SzymonLy/Quadcopter_2.1/CanSat.kicad_sch

## KiCad design CanSat.kicad_sch (2025-03-13)

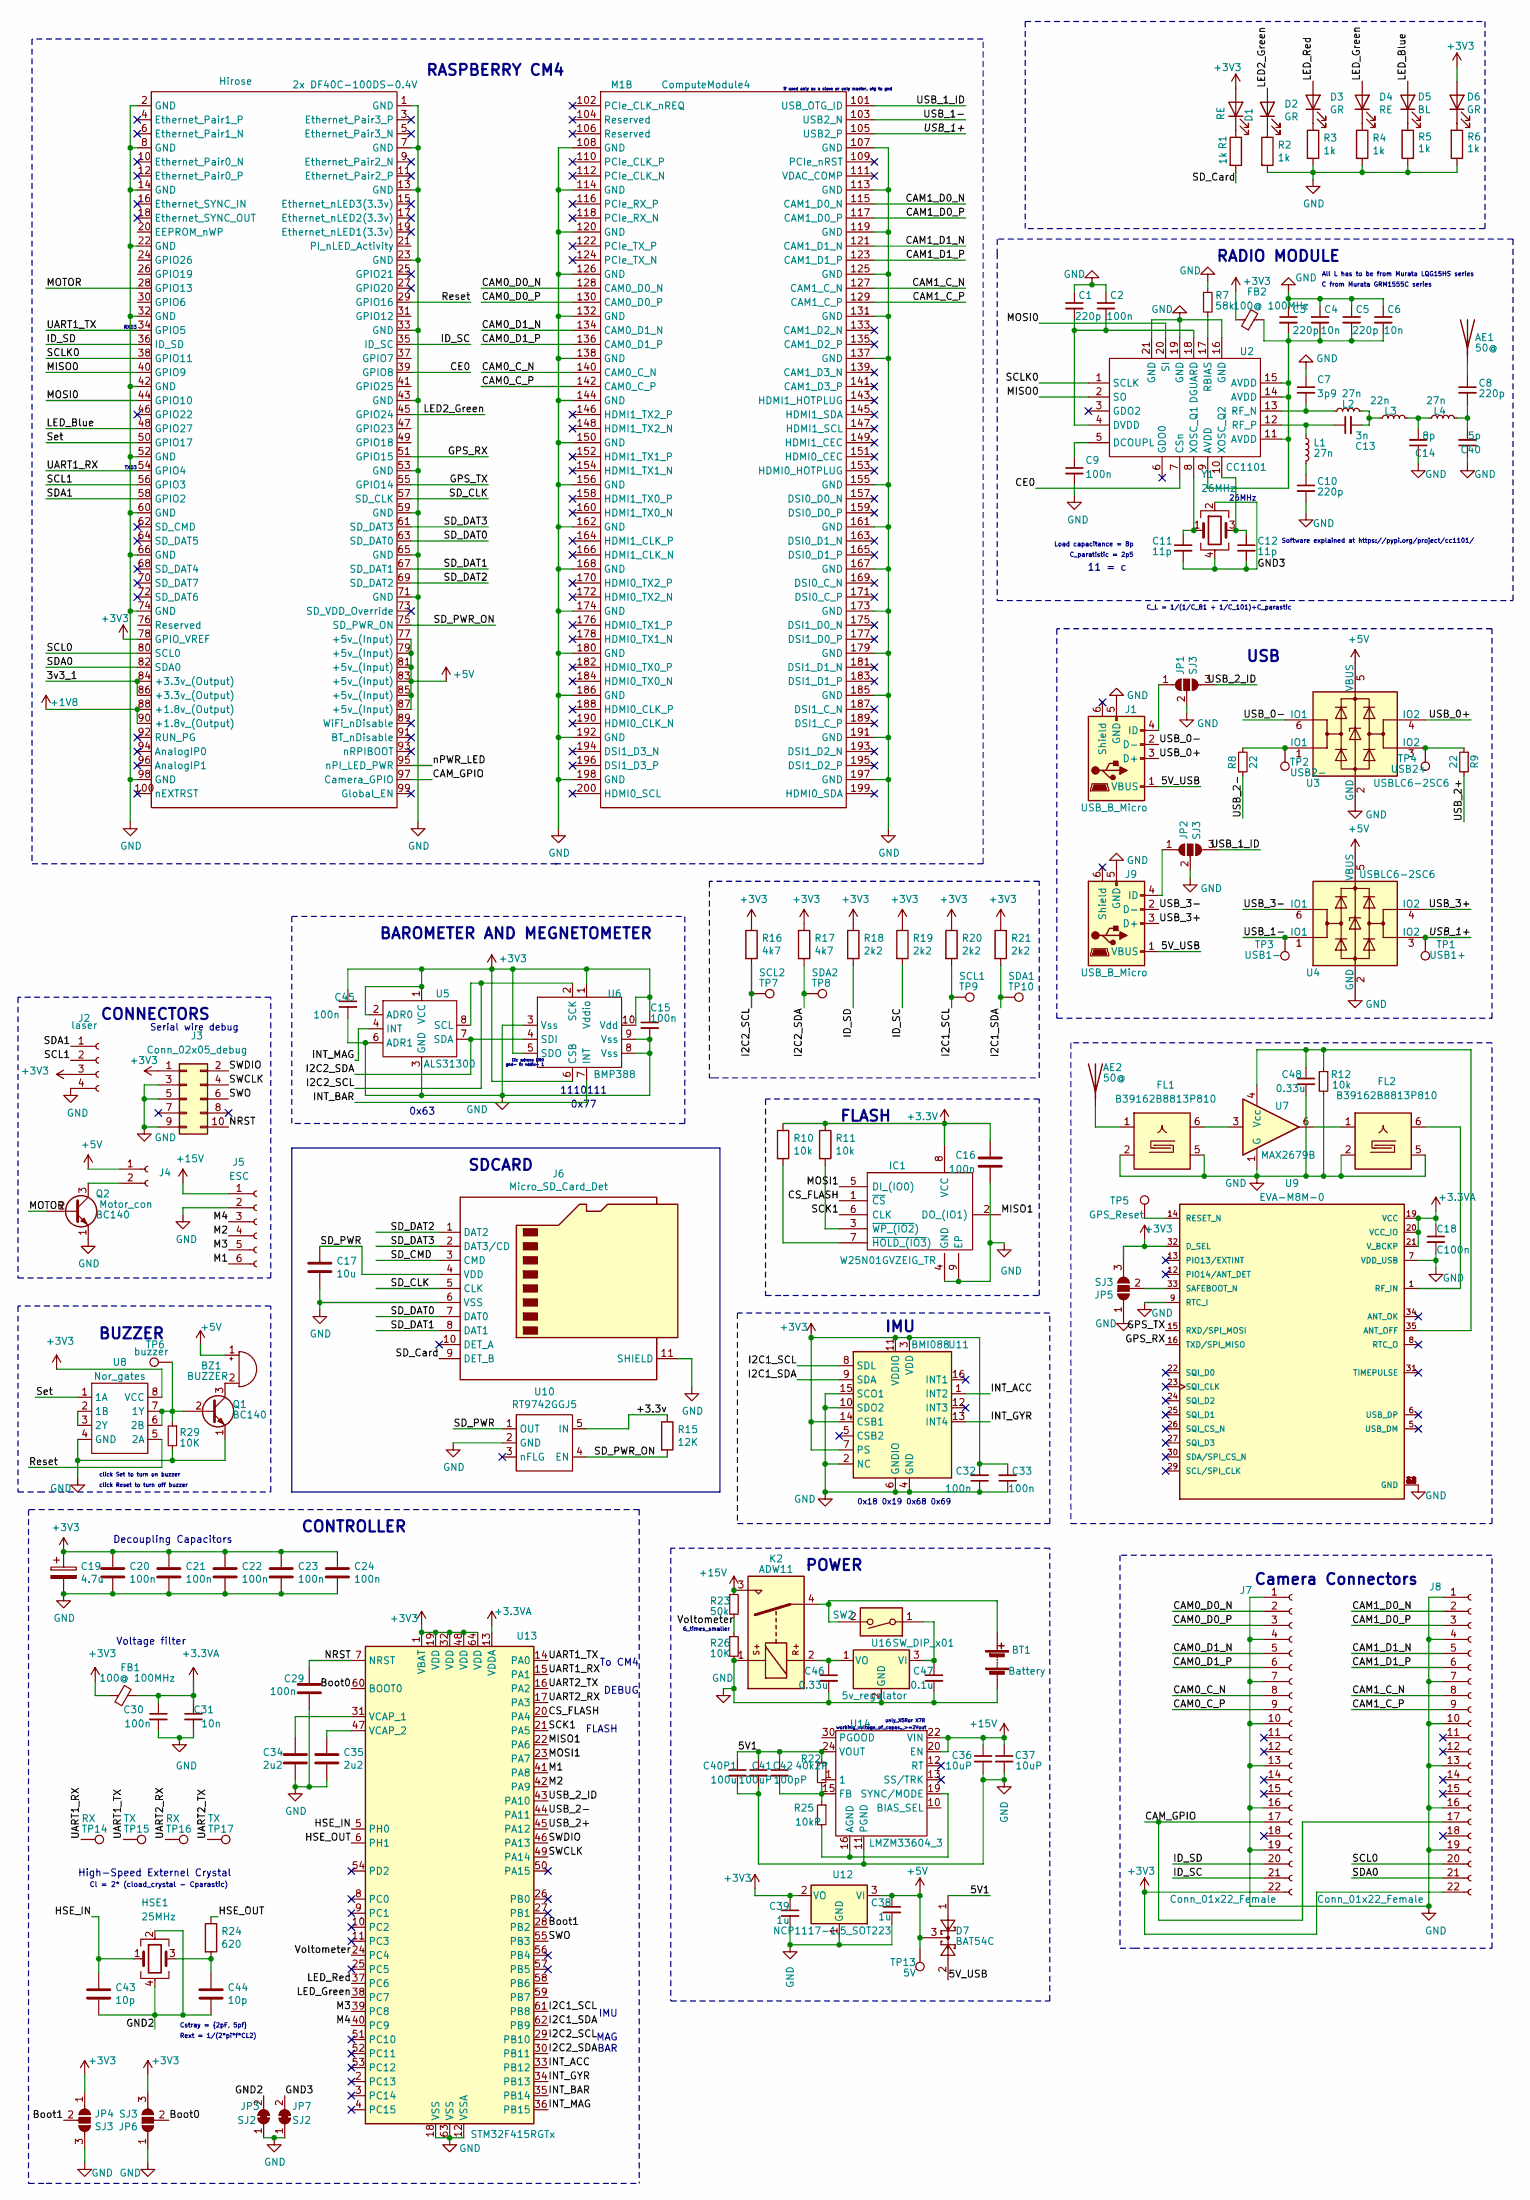
[picture p9: schematic CanSat.kicad_sch]

Parts:
AE1: 50@; 433_antenna_connector
AE2: 50@; GPS_antenna
BT1: Battery; Battery con
BZ1: BUZZER; buzzer
C1, C3, C5, C8, C10: 220p; C_0402_1005Metric
C2, C9, C15, C16, C20, C21, C22, C23, C24, C29, C30, C32, C33, C45: 100n; C_0402_1005Metric
C4, C6, C31: 10n; C_0402_1005Metric
C7: 3p9; C_0402_1005Metric
C11, C12: 11p; C_0402_1005Metric
C13: 3n; C_0402_1005Metric
C14: 8p; C_0402_1005Metric
C17: 10u; C_0402_1005Metric; Part Description 10uF 10% 10V Ceramic Capacitor X7R 0805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
C18: C100n; C_0402_1005Metric
C19: 4.7u; C_0402_1005Metric
C34, C35: 2u2; C_0402_1005Metric
C36, C37: 10uP; C10uF_Power
C38, C39: 1u; C_0402_1005Metric
C40: 5p; C_0402_1005Metric
C40P1: 100u; C10uF_Power
C41: 100uP; C10uF_Power
C42: 100pP; C_0402_1005Metric
C43, C44: 10p; C_0402_1005Metric
C46: 0.33u; C_0402_1005Metric
C47: 0.1u; C_0402_1005Metric
C48: 0.33u; C_0201_0603Metric
D1, D4: RE; diode_XQ-E
D2, D3: GR; diode_XQ-E
D5: BL; diode_XQ-E; Part Description Green 572nm LED Indication - Discrete 2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
D6: GR; diode_XQ-E; Part Description Green 572nm LED Indication - Discrete 2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
D7: BAT54C; SOT-23
FB1, FB2: 100@ 100MHz; L_0603_1608Metric
FL1, FL2: B39162B8813P810; SOT-23-6
HSE1: 25MHz; Crystal_SMD_Abracon_ABM8G-4Pin_3.2x2.5mm
IC1: W25N01GVZEIG_TR; Flash; Manufacturer_Part_Number W25N01GVZEIG TR; Mouser Part Number 454-W25N01GVZEIGTR
J1, J9: USB_B_Micro; GCT_USB3160-30-0170-0-C
J2: laser; Laser
J3: Conn_02x05_debug; Debug_connector
J4: Motor_con; Motor_connection
J5: ESC; ESC_power
J6: Micro_SD_Card_Det; GCT_MEM2075-00-140-01-A; Part Description 9 (8 + 1) Position Card Connector micro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
J7, J8: Conn_01x22_Female; Hirose_FH12-22S-0.5SH_1x22-1MP_P0.50mm_Horizontal; Part Description 22 Position FFC, FPC Connector Contacts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
JP1, JP2, JP4, JP5, JP6: SJ3; SolderJumper-3_P1.3mm_Open_RoundedPad1.0x1.5mm
JP3, JP7: SJ2; SolderJumper-2_P1.3mm_Bridged2Bar_RoundedPad1.0x1.5mm
K2: ADW11; relay
L1, L2, L4: 27n; R_0402_1005Metric
L3: 22n; R_0402_1005Metric
M1: ComputeModule4; Raspberry-Pi-4-Compute-Module
Q1, Q2: BC140; SOT-23
R1, R5, R6: 1k; R_0402_1005Metric; Part Description Resistor 1K M1005 1% 63mW
R2, R3, R4: 1k; R_0402_1005Metric
R7: 58k; R_0402_1005Metric
R8, R9: 22; R_0402_1005Metric
R10, R11, R12: 10k; R_0402_1005Metric
R15: 12K; R_0402_1005Metric; Part Description Resistor 12K M1005 1% 63mW
R16, R17: 4k7; R_0402_1005Metric
R18, R19, R20, R21: 2k2; R_0402_1005Metric
R22: 40k2P; R_1k
R23: 50k; R_0402_1005Metric
R24: 620; R_0402_1005Metric
R25: 10kP; R_0402_1005Metric
R26, R29: 10K; R_0402_1005Metric
SW2: SW_DIP_x01; Switch
TP1: USB1+; TestPoint_Pad_D1.5mm
TP2: USB2-; TestPoint_Pad_D1.5mm
TP3: USB1-; TestPoint_Pad_D1.5mm
TP4: USB2+; TestPoint_Pad_D1.5mm
TP5: GPS_Reset; TestPoint_Pad_D1.5mm
TP6: buzzer; TestPoint_Pad_D1.5mm
TP7: SCL2; TestPoint_Pad_D1.5mm
TP8: SDA2; TestPoint_Pad_D1.5mm
TP9: SCL1; TestPoint_Pad_D1.0mm
TP10: SDA1; TestPoint_Pad_D1.0mm
TP13: 5V; TestPoint_Pad_D2.0mm
TP14, TP16: RX; TestPoint_Pad_D1.5mm
TP15, TP17: TX; TestPoint_Pad_D1.5mm
U2: CC1101; Transmiter
U3, U4: USBLC6-2SC6; SOT-23-6
U5: ALS31300; Mag
U6: BMP388
U7: MAX2679B; DFN150X100X80-6N
U8: Nor_gates
U9: EVA-M8M-0; GPS; PART_REV R02
U10: RT9742GGJ5; SOT-23-5; Part Description Power Switch/Driver 1:1 N-Channel 1A TS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
U11: BMI088
U12: NCP1117-1.5_SOT223; SOT-223-3_TabPin2
U13: STM32F415RGTx; LQFP-64_10x10mm_P0.5mm
U14: LMZM33604_3; 5V_converter
U16: 5v_regulator; Reg_5v
Y1: 26MHz; Crystal_SMD_EuroQuartz_MT-4Pin_3.2x2.5mm

Connections:
3v3_1: M1.84 (+3.3v_(Output)), M1.86 (+3.3v_(Output))
5V1: C40P1.1, C41.1, C42.1, D7.1, R22.1, U14.24 (VOUT)
5V_USB: D7.2, J1.1 (VBUS), J9.1 (VBUS)
+1V8: M1.88 (+1.8v_(Output)), M1.90 (+1.8v_(Output))
+3.3VA: C18.1, C30.1, C31.1, FB1.2, U9.19 (VCC), U9.20 (VCC_IO), U9.21 (V_BCKP), U13.13 (VDDA)
+3.3v: C16.2, IC1.8 (VCC), R10.1, R11.1, R15.1, U10.5 (IN)
+3V3: C15.1, C19.1, C20.1, C21.1, C22.1, C23.1, C24.1, C32.2, C33.2, C39.1, C45.1, D1.2 (A), D6.2 (A), FB1.1, FB2.1, J2.3, J3.1, J7.22, J8.22, JP4.1 (A), JP5.3 (B), JP6.3 (B), M1.78 (GPIO_VREF(1.8v/3.3v_Input)), R16.1, R17.1, R18.1, R19.1, R20.1, R21.1, U5.1 (VCC), U5.2 (ADR0), U6.1 (Vddio), U6.5 (SDO), U6.6 (CSB), U6.10 (Vdd), U8.8 (VCC), U9.32 (D_SEL), U11.3 (VDD), U11.7 (PS), U11.11 (VDDIO), U11.14 (CSB1), U12.2 (VO), U13.1 (VBAT), U13.19 (VDD), U13.32 (VDD), U13.48 (VDD), U13.64 (VDD)
+5V: BZ1.1 (-), C38.1, D7.3, J4.1, M1.77 (+5v_(Input)), M1.79 (+5v_(Input)), M1.81 (+5v_(Input)), M1.83 (+5v_(Input)), M1.85 (+5v_(Input)), M1.87 (+5v_(Input)), TP13.1, U3.5 (VBUS), U4.5 (VBUS), U12.3 (VI)
+15V: C36.1, C37.1, J5.1, K2.3, R23.1, U14.20 (EN), U14.22 (VIN)
Boot0: JP6.2 (C), U13.60 (BOOT0)
Boot1: JP4.2 (C), U13.28 (PB2)
CAM0_C_N: J7.8, M1.140 (CAM0_C_N)
CAM0_C_P: J7.9, M1.142 (CAM0_C_P)
CAM0_D0_N: J7.2, M1.128 (CAM0_D0_N)
CAM0_D0_P: J7.3, M1.130 (CAM0_D0_P)
CAM0_D1_N: J7.5, M1.134 (CAM0_D1_N)
CAM0_D1_P: J7.6, M1.136 (CAM0_D1_P)
CAM1_C_N: J8.8, M1.127 (CAM1_C_N)
CAM1_C_P: J8.9, M1.129 (CAM1_C_P)
CAM1_D0_N: J8.2, M1.115 (CAM1_D0_N)
CAM1_D0_P: J8.3, M1.117 (CAM1_D0_P)
CAM1_D1_N: J8.5, M1.121 (CAM1_D1_N)
CAM1_D1_P: J8.6, M1.123 (CAM1_D1_P)
CAM_GPIO: J7.17, J8.17, M1.97 (Camera_GPIO)
CE0: M1.39 (GPIO8), U2.7 (CSn)
CS_FLASH: IC1.1 (~CS), U13.20 (PA4)
GND: BT1.2 (-), C1.1, C2.1, C3.1, C4.1, C5.1, C6.1, C7.1, C9.2, C10.2, C14.1, C15.2, C16.1, C17.2, C18.2, C19.2, C20.2, C21.2, C22.2, C23.2, C24.2, C29.2, C30.2, C31.2, C32.1, C33.1, C34.2, C35.2, C36.2, C37.2, C38.2, C39.2, C40.1, C40P1.2, C41.2, C45.2, C46.2, C47.2, C48.2, FL1.2, FL1.5, FL2.2, FL2.5, IC1.4 (GND), IC1.9 (EP), J1.5 (GND), J2.4, J3.3, J3.5, J3.9, J5.2, J6.6 (VSS), J6.11 (SHIELD), J7.1, J7.4, J7.7, J7.10, J7.13, J7.16, J7.19, J8.1, J8.4, J8.7, J8.10, J8.13, J8.16, J8.19, J9.5 (GND), JP1.2 (C), JP2.2 (C), JP3.1 (A), JP4.3 (B), JP5.1 (A), JP6.1 (A), JP7.1 (A), K2.1, M1.1 (GND), M1.2 (GND), M1.7 (GND), M1.8 (GND), M1.13 (GND), M1.14 (GND), M1.22 (GND), M1.23 (GND), M1.32 (GND), M1.33 (GND), M1.42 (GND), M1.43 (GND), M1.52 (GND), M1.53 (GND), M1.59 (GND), M1.60 (GND), M1.65 (GND), M1.66 (GND), M1.71 (GND), M1.74 (GND), M1.98 (GND), M1.107 (GND), M1.108 (GND), M1.113 (GND), M1.114 (GND), M1.119 (GND), M1.120 (GND), M1.125 (GND), M1.126 (GND), M1.131 (GND), M1.132 (GND), M1.137 (GND), M1.138 (GND), M1.144 (GND), M1.150 (GND), M1.155 (GND), M1.156 (GND), M1.161 (GND), M1.162 (GND), M1.167 (GND), M1.168 (GND), M1.173 (GND), M1.174 (GND), M1.179 (GND), M1.180 (GND), M1.185 (GND), M1.186 (GND), M1.191 (GND), M1.192 (GND), M1.197 (GND), M1.198 (GND), Q1.1 (E), Q2.1 (E), R2.2, R3.2, R4.2, R5.1, R6.1, R7.1, R12.2, R26.2, R29.2, U2.16 (GND), U2.19 (GND), U2.21 (GND), U3.2 (GND), U4.2 (GND), U5.3 (GND), U5.6 (ADR1), U6.3 (Vss), U6.8 (Vss), U6.9 (Vss), U7.1 (G), U8.4 (GND), U9.2 (GND), U9.7 (VDD_USB), U9.9 (RTC_I), U9.18 (GND), U9.37 (GND), U9.38 (GND), U9.39 (GND), U9.40 (GND), U9.41 (GND), U9.42 (GND), U9.43 (GND), U10.2 (GND), U11.2 (NC), U11.4 (GND), U11.6 (GNDIO), U11.10 (SDO2), U11.15 (SCO1), U12.1 (GND), U13.12 (VSSA), U13.18 (VSS), U13.63 (VSS), U14.11 (PGND), U16.2 (GND)
GND2: C43.2, C44.2, HSE1.2, HSE1.4, JP3.2 (B)
GND3: C11.2, C12.2, JP7.2 (B), Y1.2, Y1.4
GPS_RX: M1.51 (GPIO15), U9.16 (TXD/SPI_MISO)
GPS_TX: M1.55 (GPIO14), U9.15 (RXD/SPI_MOSI)
HSE_IN: C43.1, HSE1.1, U13.5 (PH0)
HSE_OUT: R24.1, U13.6 (PH1)
I2C1_SCL: R20.2, TP9.1, U11.8 (SDL), U13.61 (PB8)
I2C1_SDA: R21.2, TP10.1, U11.9 (SDA), U13.62 (PB9)
I2C2_SCL: R16.2, TP7.1, U5.8 (SCL), U6.2 (SCK), U13.29 (PB10)
I2C2_SDA: R17.2, TP8.1, U5.7 (SDA), U6.4 (SDI), U13.30 (PB11)
ID_SC: J7.21, M1.35 (ID_SC), R19.2
ID_SD: J7.20, M1.36 (ID_SD), R18.2
INT_ACC: U11.1 (INT2), U13.33 (PB12)
INT_BAR: U6.7 (INT), U13.35 (PB14)
INT_GYR: U11.13 (INT4), U13.34 (PB13)
INT_MAG: U5.4 (INT), U13.36 (PB15)
LED2_Green: D2.2 (A), M1.45 (GPIO24)
LED_Blue: D5.2 (A), M1.48 (GPIO27)
LED_Green: D4.2 (A), U13.38 (PC7)
LED_Red: D3.2 (A), U13.37 (PC6)
M1: J5.6, U13.41 (PA8)
M2: J5.4, U13.42 (PA9)
M3: J5.5, U13.39 (PC8)
M4: J5.3, U13.40 (PC9)
MISO0: M1.40 (GPIO9), U2.2 (SO)
MISO1: IC1.2 (DO_(IO1)), U13.22 (PA6)
MOSI0: M1.44 (GPIO10), U2.20 (SI)
MOSI1: IC1.5 (DI_(IO0)), U13.23 (PA7)
MOTOR: M1.28 (GPIO13), Q2.2 (B)
NRST: C29.1, J3.10, U13.7 (NRST)
unnamed: AE1.1, C8.1
unnamed: AE2.1, FL1.1
unnamed: BT1.1 (+), K2.4, SW2.2
unnamed: BZ1.2 (+), Q1.3 (C)
unnamed: C1.2, C2.2, U2.4 (DVDD), U2.18 (DGUARD)
unnamed: C3.2, C4.2, C5.2, C6.2, FB2.2, U2.9 (AVDD), U2.11 (AVDD), U2.14 (AVDD), U2.15 (AVDD)
unnamed: C7.2, L2.1, U2.13 (RF_N)
unnamed: C9.1, U2.5 (DCOUPL)
unnamed: C10.1, L1.2
unnamed: C11.1, U2.8 (XOSC_Q1), Y1.1
unnamed: C12.1, U2.10 (XOSC_Q2), Y1.3
unnamed: C13.1, L1.1, U2.12 (RF_P)
unnamed: C13.2, L2.2, L3.1
unnamed: C14.2, L3.2, L4.1
unnamed: C34.1, U13.31 (VCAP_1)
unnamed: C35.1, U13.47 (VCAP_2)
unnamed: C8.2, C40.2, L4.2
unnamed: C42.2, R22.2, R25.1, U14.15 (FB)
unnamed: C44.1, HSE1.3, R24.2
unnamed: C46.1, K2.2, U16.1 (VO)
unnamed: C47.1, SW2.1, U16.3 (VI)
unnamed: C48.1, R12.1, U7.4 (Vcc), U9.35 (ANT_OFF)
unnamed: D1.1 (K), R1.1
unnamed: D2.1 (K), R2.1
unnamed: D3.1 (K), R3.1
unnamed: D4.1 (K), R4.1
unnamed: D5.1 (K), R5.2
unnamed: D6.1 (K), R6.2
unnamed: FL1.6, U7.3
unnamed: FL2.1, U7.6
unnamed: FL2.6, U9.1 (RF_IN)
unnamed: IC1.3 (~WP_(IO2)), R11.2
unnamed: IC1.7 (~HOLD_(IO3)), R10.2
unnamed: J1.4 (ID), JP1.1 (A)
unnamed: J4.2, Q2.3 (C)
unnamed: J9.4 (ID), JP2.1 (A)
unnamed: JP5.2 (C), U9.33 (SAFEBOOT_N)
unnamed: Q1.2 (B), R29.1, TP6.1, U8.6 (2B), U8.7 (1Y)
unnamed: R7.2, U2.17 (RBIAS)
unnamed: R8.2, TP2.1, U3.1 (IO1)
unnamed: R9.1, TP4.1, U3.3 (IO2)
unnamed: R25.2, U14.16 (AGND), U14.19 (SYNC/MODE)
unnamed: TP5.1, U9.14 (RESET_N)
unnamed: U8.2 (1B), U8.3 (2Y)
Reset: M1.29 (GPIO16), U8.5 (2A)
SCK1: IC1.6 (CLK), U13.21 (PA5)
SCL0: J8.20, M1.80 (SCL0)
SCL1: J2.2, M1.56 (GPIO3)
SCLK0: M1.38 (GPIO11), U2.1 (SCLK)
SDA0: J8.21, M1.82 (SDA0)
SDA1: J2.1, M1.58 (GPIO2)
SD_CLK: J6.5 (CLK), M1.57 (SD_CLK)
SD_CMD: J6.3 (CMD)
SD_Card: J6.9 (DET_B), R1.2
SD_DAT0: J6.7 (DAT0), M1.63 (SD_DAT0)
SD_DAT1: J6.8 (DAT1), M1.67 (SD_DAT1)
SD_DAT2: J6.1 (DAT2), M1.69 (SD_DAT2)
SD_DAT3: J6.2 (DAT3/CD), M1.61 (SD_DAT3)
SD_PWR: C17.1, J6.4 (VDD), U10.1 (OUT)
SD_PWR_ON: M1.75 (SD_PWR_ON), R15.2, U10.4 (EN)
SWCLK: J3.4, U13.49 (PA14)
SWDIO: J3.2, U13.46 (PA13)
SWO: J3.6, U13.55 (PB3)
Set: M1.50 (GPIO17), U8.1 (1A)
UART1_RX: M1.54 (GPIO4), TP14.1, U13.15 (PA1)
UART1_TX: M1.34 (GPIO5), TP15.1, U13.14 (PA0)
UART2_RX: TP16.1, U13.17 (PA3)
UART2_TX: TP17.1, U13.16 (PA2)
USB_0+: J1.3 (D+), U3.4 (IO2)
USB_0-: J1.2 (D-), U3.6 (IO1)
USB_1+: M1.105 (USB2_P), TP1.1, U4.3 (IO2)
USB_1-: M1.103 (USB2_N), TP3.1, U4.1 (IO1)
USB_1_ID: JP2.3 (B), M1.101 (USB_OTG_ID)
USB_2+: R9.2, U13.45 (PA12)
USB_2-: R8.1, U13.44 (PA11)
USB_2_ID: JP1.3 (B), U13.43 (PA10)
USB_3+: J9.3 (D+), U4.4 (IO2)
USB_3-: J9.2 (D-), U4.6 (IO1)
Voltometer: R23.2, R26.1, U13.24 (PC4)
nPWR_LED: M1.95 (nPI_LED_PWR)

Notes on the sheet:
High-Speed Externel Crystal
click Set to turn on buzzer
click Reset to turn off buzzer
Decoupling Capacitors
RXD3
TXD3
BUZZER
Cstray = {2pF, 5pf}
Rext = 1/(2*pi*f*CL2)
Voltage filter
CONNECTORS
Cl = 2* (cload_crystal - Cparastic)
Serial wire debug
CONTROLLER
0x63
SDCARD
i2c adress bit0 gnd- 0; vddio- 1
RASPBERRY CM4
0x77
1110111
FLASH
IMU
MAG BAR
To CM4
DEBUG
BAROMETER AND MEGNETOMETER
6_times_smaller
if used only as a slave or only master, otg to gnd
working_voltage_of_capas._>=2Vout
FLASH
POWER
only_X5Ror X7R
IMU
0x18 0x19 0x68 0x69
11 = c
Load capacitance = 8p
C_paratistic = 2p5
Camera Connectors
26MHz
USB
C_L = 1/(1/C_81 + 1/C_101)+C_parastic
RADIO MODULE
C from Murata GRM1555C series
All L has to be from Murata LQG15HS series
Software explained at https://pypi.org/project/cc1101/
